radi8/TR-Switch/Photo1.jpg

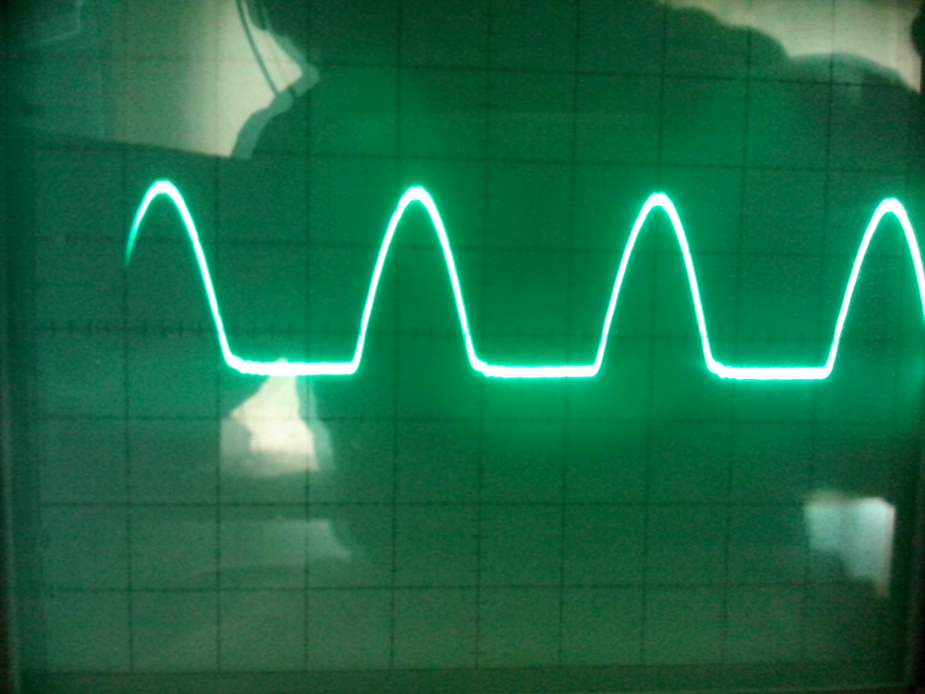
Photo1.jpg
