radi8/TR-Switch/Photo2.jpg

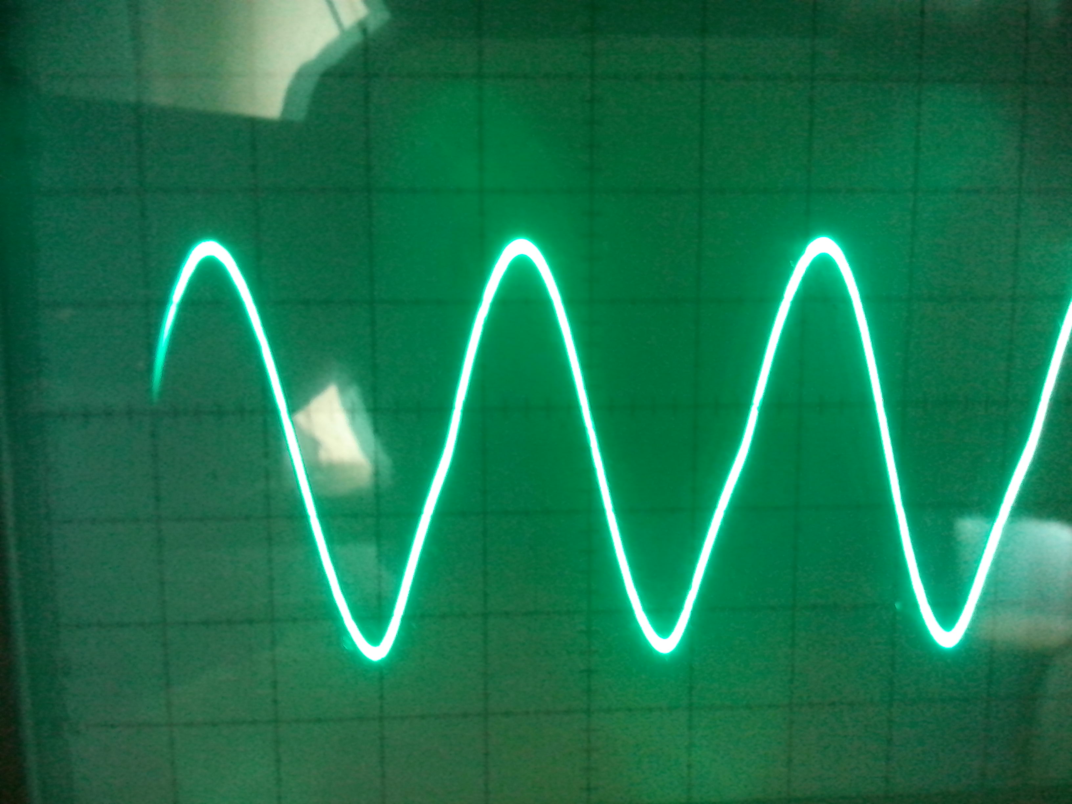
Photo2.jpg
