radi8/TR-Switch/README

This is the development of an article on making a TR-Switch using common rectifier diodes as a PIN diode substitute.
