radi8/TR-Switch/FinalGraphs/VNA_140301_164818.pdf

# Through Capacitors with diodes bridged, no chokes

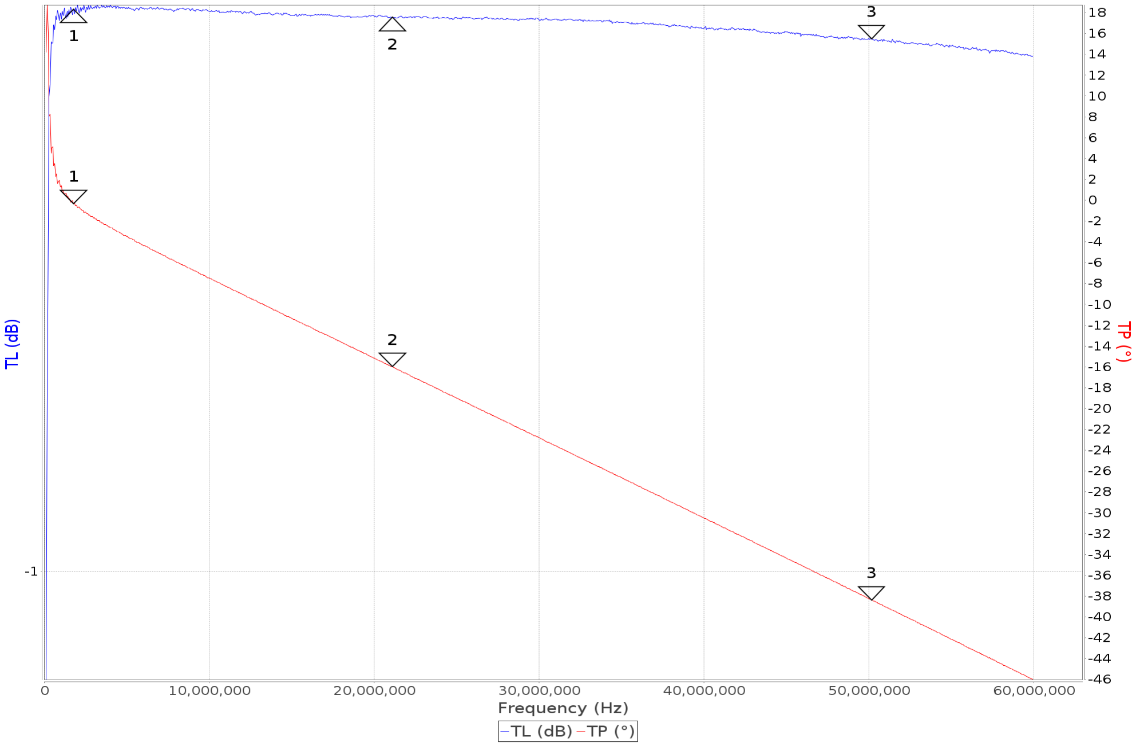
[picture p3: figure]

## Comment:

Date: | 1/03/14 4:48 PM
Mode: | Transmission
Analyser: | miniVNA-pro / mini radio solutions - miniVNA pro
Scan
Start: | 100000 / 100,000
Stop: | 59999917 / 59,999,917
Samples: 1047
Overscan: 1
Calibration
Samples: 2000
Overscan: 1
File: | TRAN_miniVNA-pro.cal
User: | gvj

## Plot generated on 1/03/2014, 4:48:19 PM

Marker | Freq. (Hz) | RL (dB) | RP (°) | TL (dB) | TP (°) | SWR | |Z| () | Rs () | Xs ()
1 | 1,759,119 | 0.00 | 0.00 | -0.04 | -0.32 | 0.00:1 | 0.0 | 0.0 | 0.0
2 | 21,096,437 | 0.00 | 0.00 | -0.06 | -15.98 | 0.00:1 | 0.0 | 0.0 | 0.0
1-2 | 19,337,318 | 0.00 | 0.00 | 0.01 | 15.66 | --- | 0.0 | 0.0 | 0.0
3 | 50,159,625 | 0.00 | 0.00 | -0.09 | -38.39 | 0.00:1 | 0.0 | 0.0 | 0.0
© DL2SBA 2013 | vna/J Version 2.8.6c | http://vnaj.dl2sba.com

## Plot generated on 1/03/2014, 4:48:19 PM

© DL2SBA 2013 | vna/J Version 2.8.6c | http://vnaj.dl2sba.com
