radi8/TR-Switch/FinalGraphs/VNA_140301_170526.pdf

# Antenna choke installed

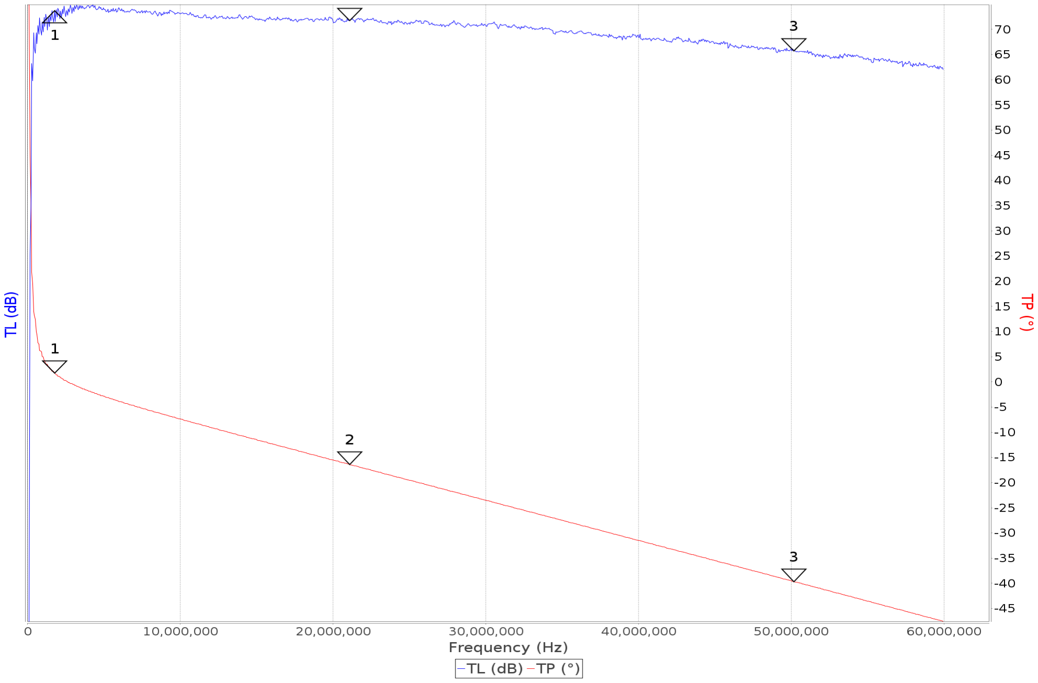
[picture p4: figure]

## Comment:

Date: | 1/03/14 5:05 PM
Mode: | Transmission
Analyser: | miniVNA-pro / mini radio solutions - miniVNA pro
Scan
Start: | 100000 / 100,000
Stop: | 59999917 / 59,999,917
Samples: 1047
Overscan: 1
Calibration
Samples: 2000
Overscan: 1
File: | ---
User: | gvj

## Plot generated on 1/03/2014, 5:05:26 PM

Marker | Freq. (Hz) | RL (dB) | RP (°) | TL (dB) | TP (°) | SWR | |Z| () | Rs () | Xs ()
1 | 1,759,119 | 0.00 | 0.00 | -0.04 | 1.73 | 0.00:1 | 0.0 | 0.0 | 0.0
2 | 21,096,437 | 0.00 | 0.00 | -0.05 | -16.38 | 0.00:1 | 0.0 | 0.0 | 0.0
1-2 | 19,337,318 | 0.00 | 0.00 | 0.01 | 18.11 | --- | 0.0 | 0.0 | 0.0
3 | 50,159,625 | 0.00 | 0.00 | -0.08 | -39.66 | 0.00:1 | 0.0 | 0.0 | 0.0
© DL2SBA 2013 | vna/J Version 2.8.6c | http://vnaj.dl2sba.com
