radi8/TR-Switch/CvsV.png

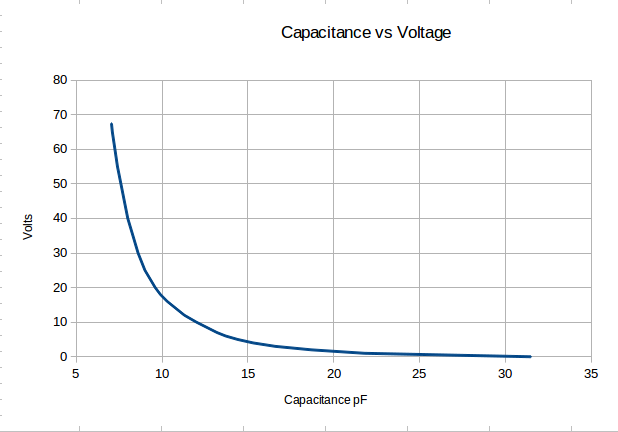
CvsV.png
