radi8/TR-Switch/CvsVplusLegend.png

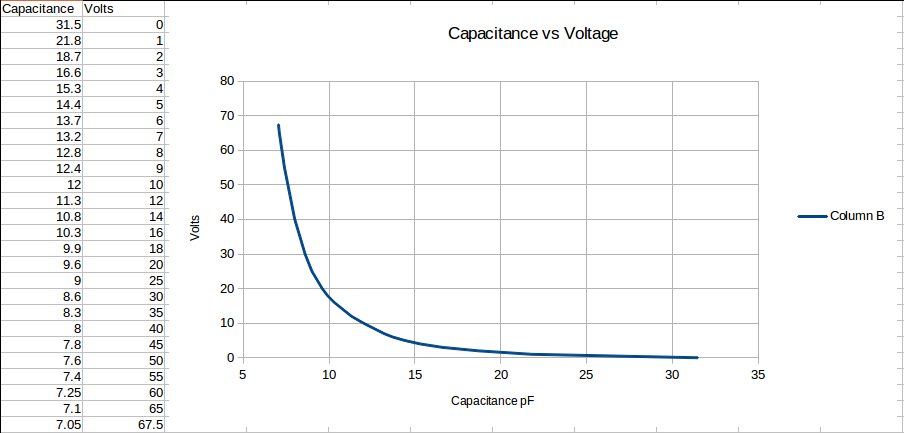
CvsVplusLegend.png
