radi8/TR-Switch/fig1_PIN.jpg

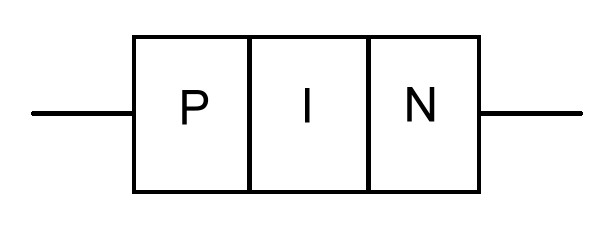
fig1_PIN.jpg
