radi8/TR-Switch/fig2.png

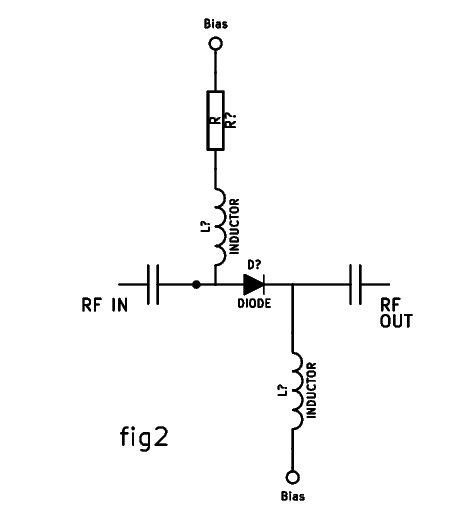
fig2.png
