radi8/TR-Switch/fig3.png

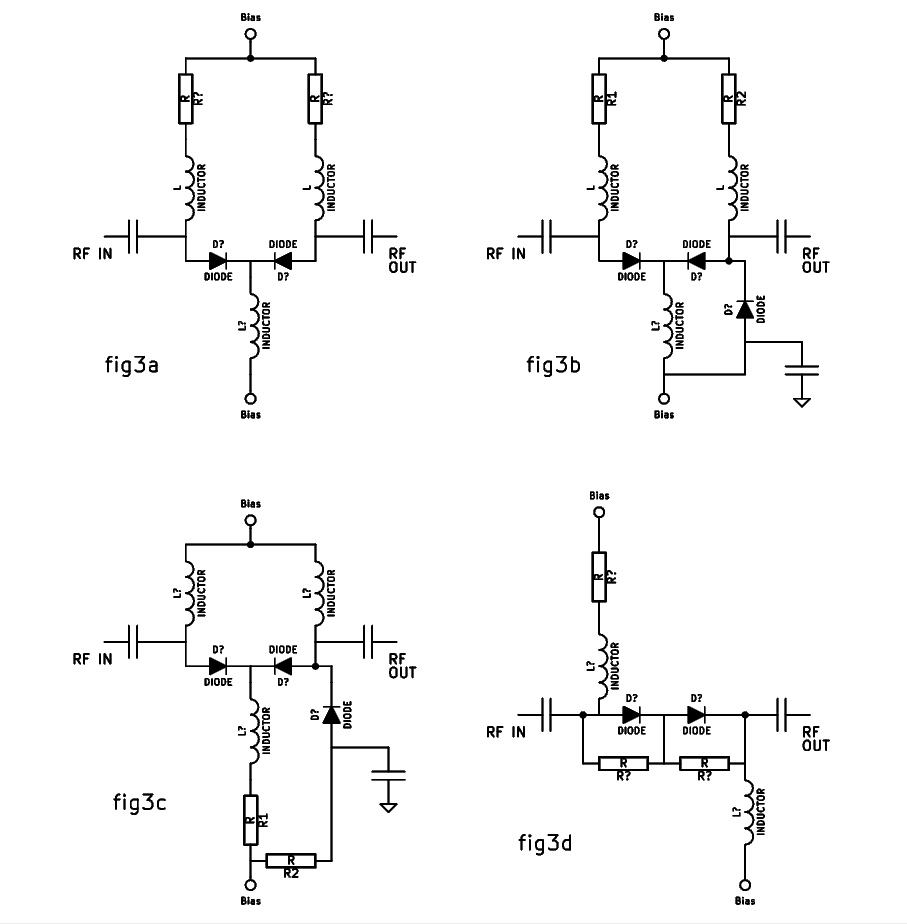
fig3.png
