radi8/TR-Switch/fig4.jpg

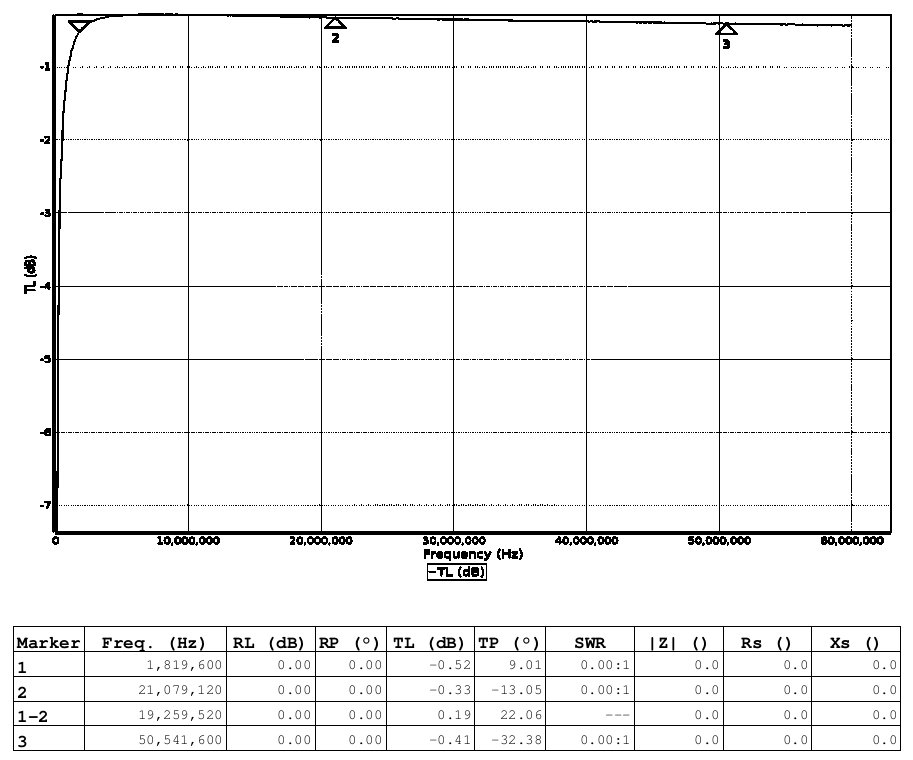
fig4.jpg
