radi8/TR-Switch/fig4.png

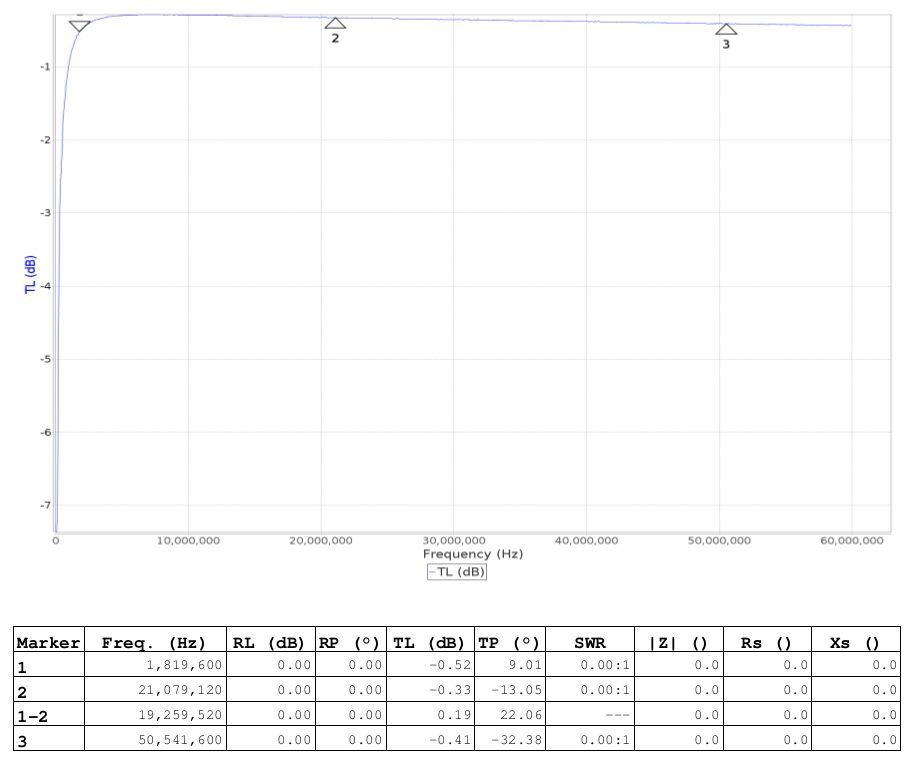
fig4.png
