radi8/TR-Switch/fig5.png

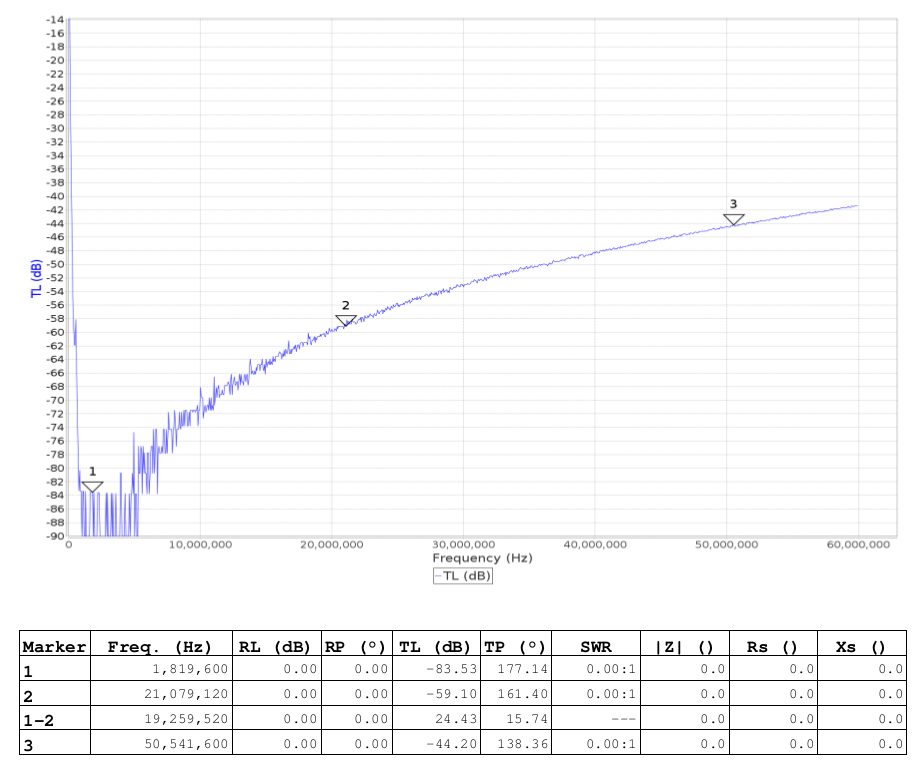
fig5.png
