radi8/TR-Switch/GP10Ycap.png

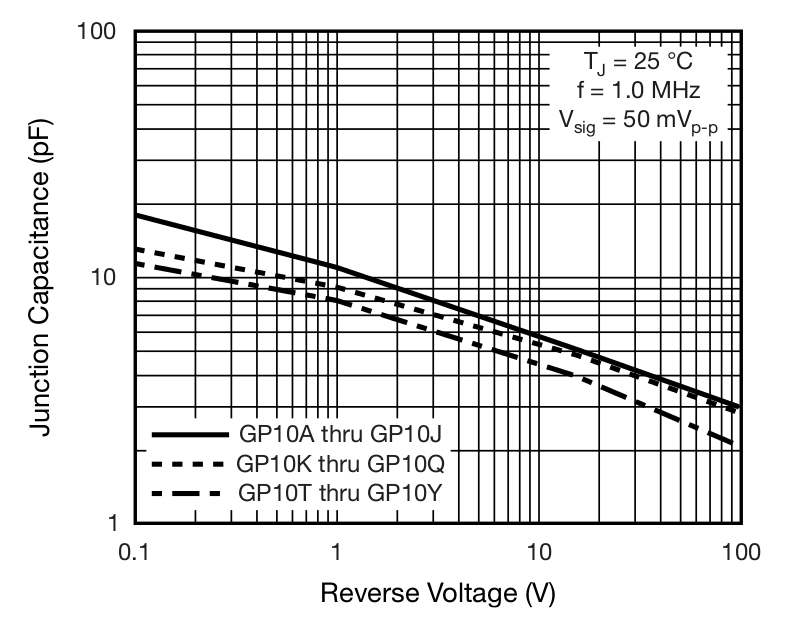
GP10Ycap.png
