radi8/TR-Switch/Resource/H-Bridge.gif

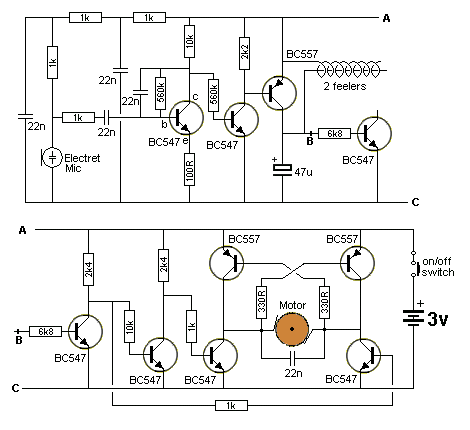
Resource/H-Bridge.gif
