radi8/TR-Switch/Resource/One-InputH_Bridge.gif

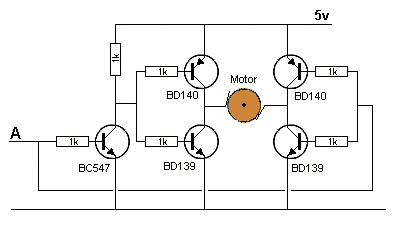
Resource/One-InputH_Bridge.gif
