radi8/TR-Switch/Screenshot from 2014-02-13 13:12:25.png

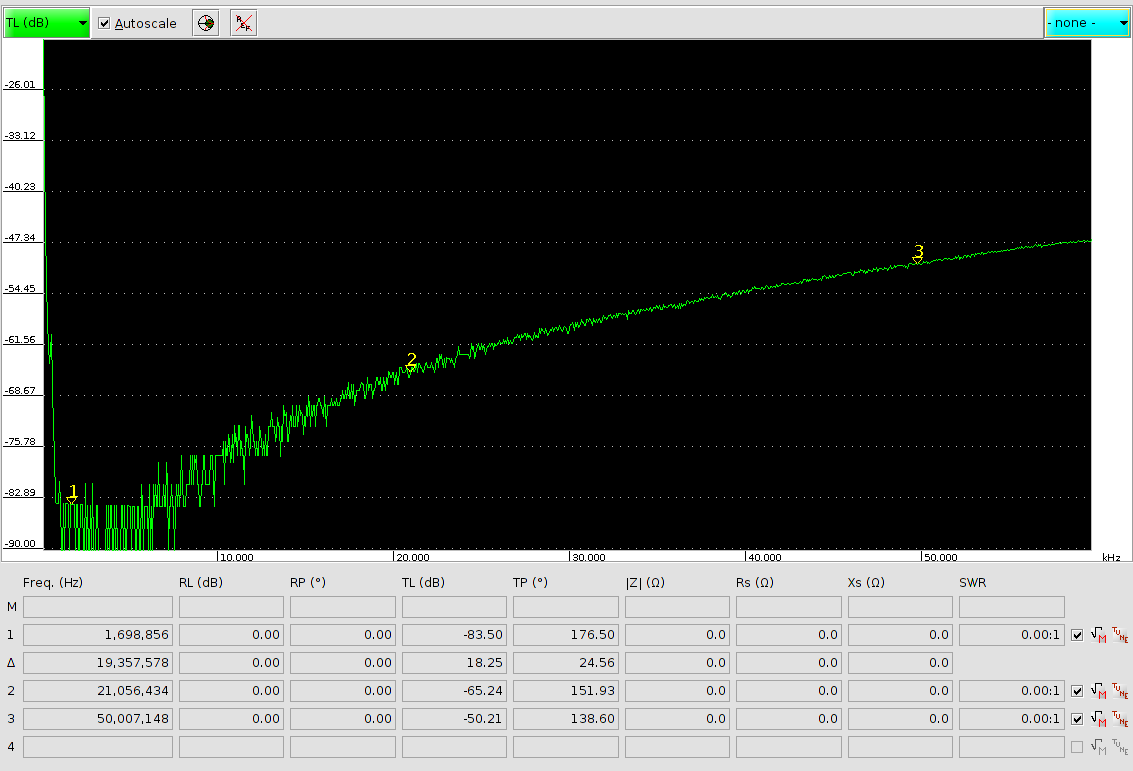
Screenshot from 2014-02-13 13:12:25.png
