radi8/TR-Switch/Table1.png

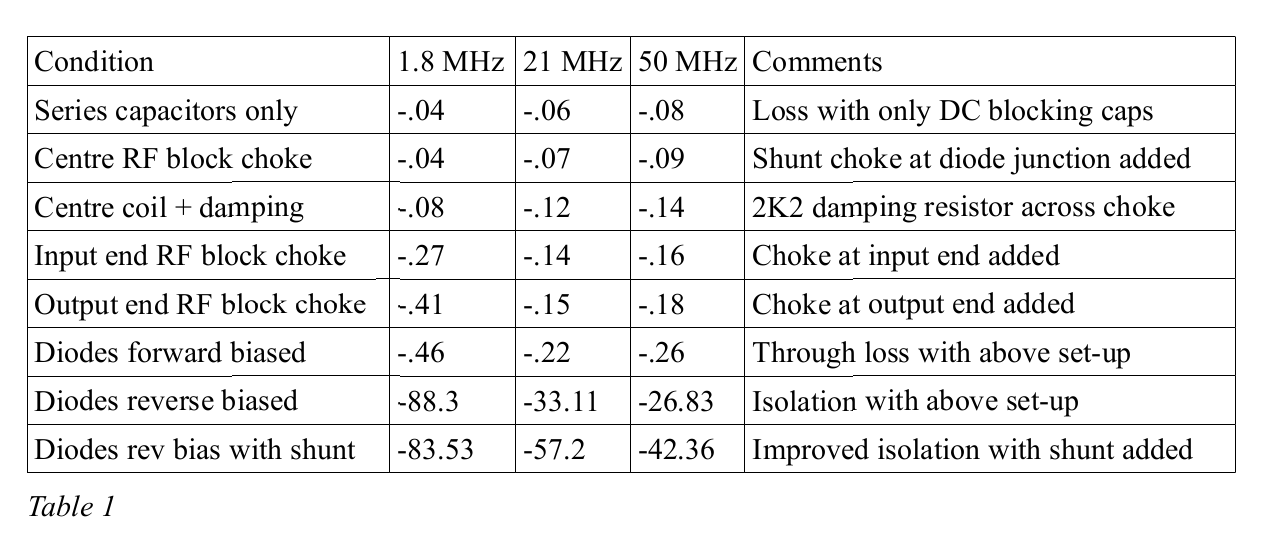
Table1.png
