radi8/TR-Switch/TRswitch/TRswitch.sch

## KiCad design TRswitch/TRswitch.sch (2014-02-20)

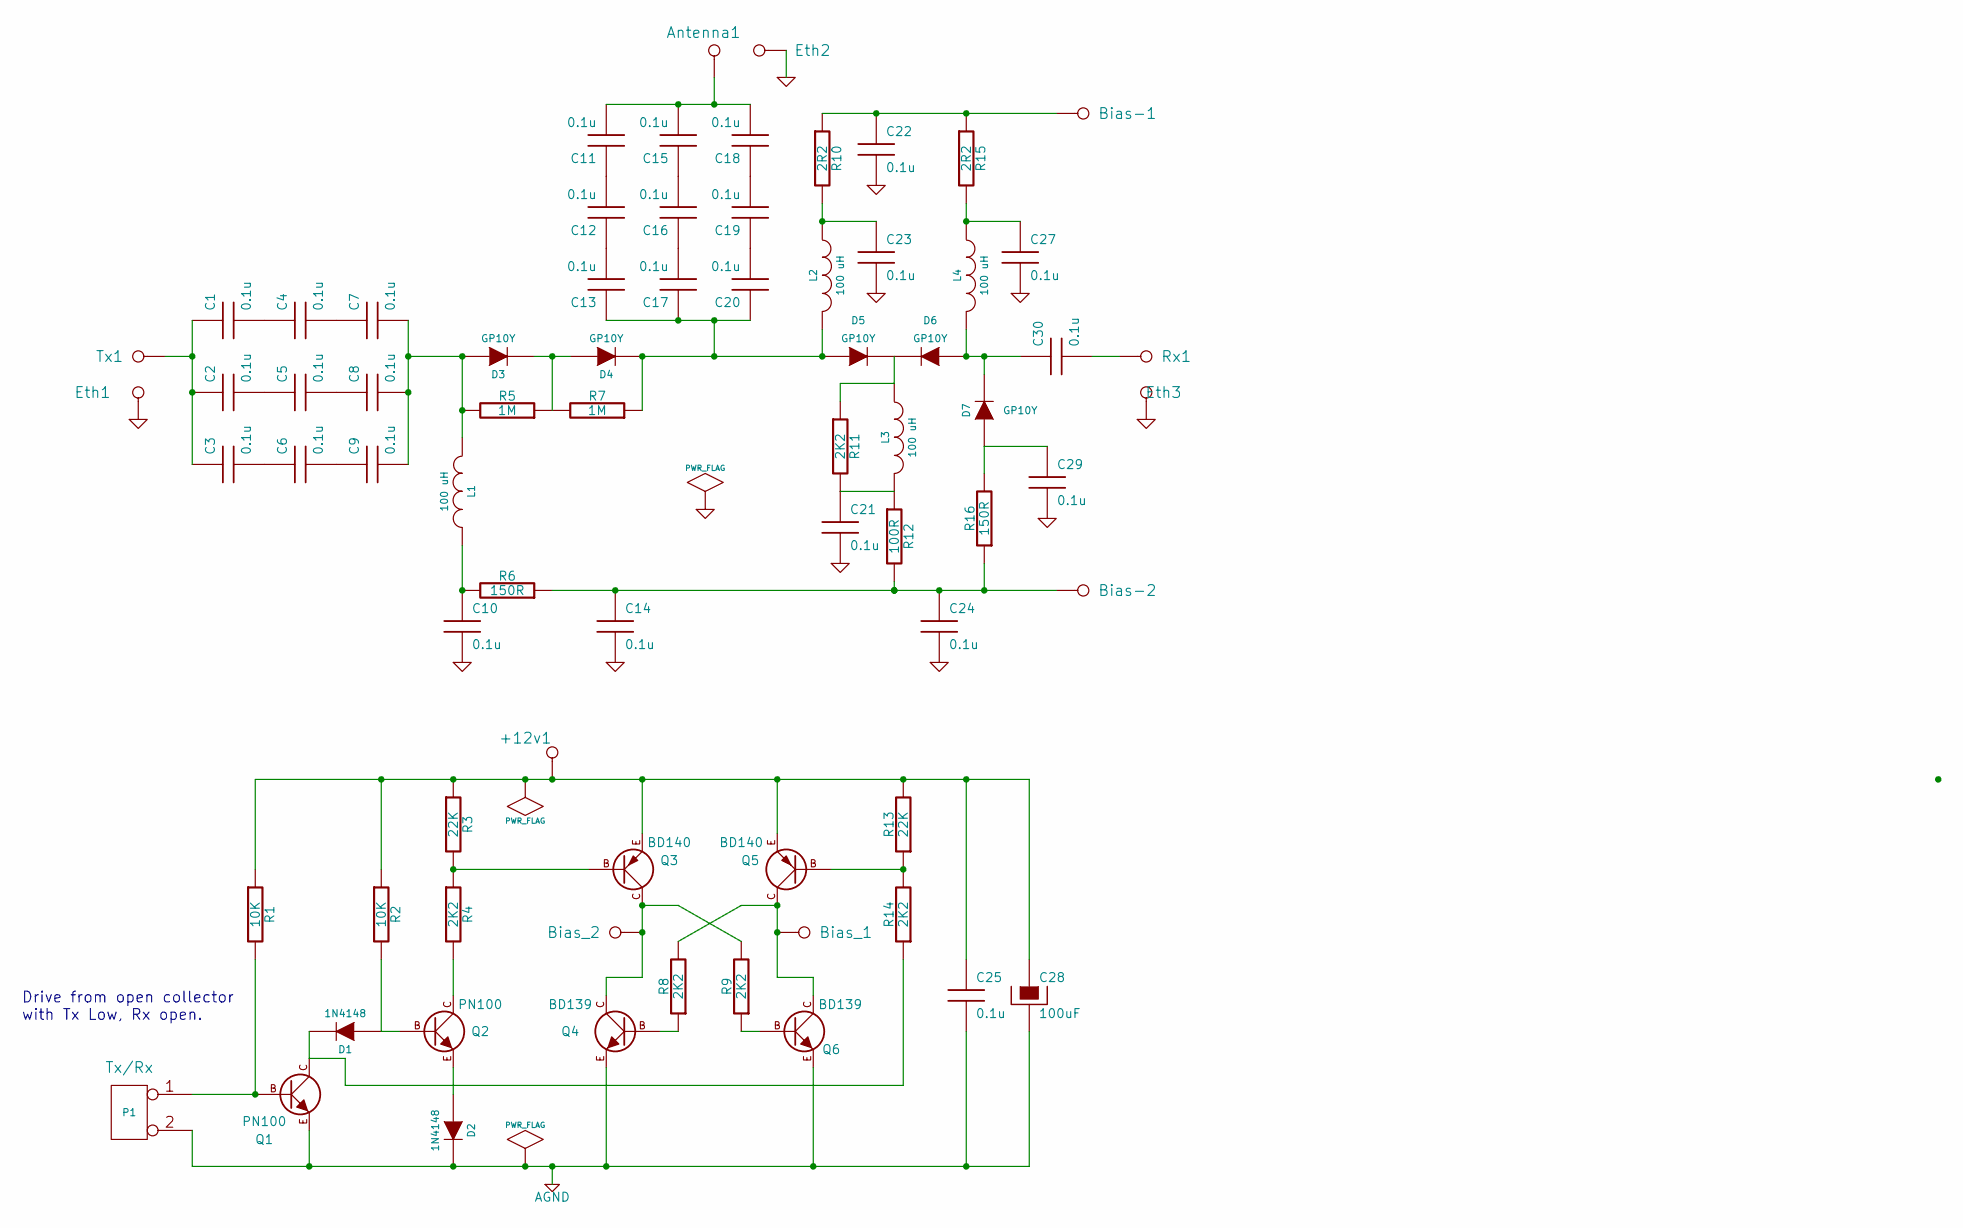
[picture p23: schematic TRswitch.sch]

Parts:
+12v1: CONN_1
Antenna1: CONN_1
Bias-1, Bias-2: CONN_1
Bias_1, Bias_2: CONN_1
C1, C2, C3, C4, C5, C6, C7, C8, C9, C10, C11, C12, C13, C14, C15, C16, C17, C18, C19, C20, C21, C22, C23, C24, C25, C27, C29, C30: 0.1u
C28: 100uF
D1, D2: 1N4148
D3, D4, D5, D6, D7: GP10Y
Eth1, Eth2, Eth3: CONN_1
L1, L2, L3, L4: 100 uH
P1: Tx/Rx
Q1, Q2: PN100; TO92-EBC
Q3, Q5: BD140
Q4, Q6: BD139; TO92-EBC
R1, R2: 10K
R3, R13: 22K
R4, R8, R9, R11, R14: 2K2
R5, R7: 1M
R6, R16: 150R
R10, R15: 2R2
R12: 100R
Rx1: CONN_1
Tx1: CONN_1

Connections:
AGND: C25.2, C28.2, D2.2 (K), P1.2 (PM), Q1.E, Q4.E, Q6.E
GND: C10.2, C14.2, C21.2, C22.2, C23.2, C24.2, C27.2, C29.2, Eth1.1, Eth2.1, Eth3.1
unnamed: +12v1.1, C25.1, C28.1, Q3.E, Q5.E, R1.1, R2.1, R3.1, R13.2
unnamed: Antenna1.1, C11.2, C15.2, C18.2
unnamed: Bias-1.1, C22.1, R10.1, R15.1
unnamed: Bias-2.1, C14.1, C24.1, R6.1, R12.2, R16.1
unnamed: Bias_1.1, Q5.C, Q6.C, R8.2
unnamed: Bias_2.1, Q3.C, Q4.C, R9.2
unnamed: C1.1, C2.1, C3.1, Tx1.1
unnamed: C1.2, C4.1
unnamed: C2.2, C5.1
unnamed: C3.2, C6.1
unnamed: C4.2, C7.1
unnamed: C5.2, C8.1
unnamed: C6.2, C9.1
unnamed: C7.2, C8.2, C9.2, D3.1 (A), L1.1, R5.2
unnamed: C10.1, L1.2, R6.2
unnamed: C11.1, C12.2
unnamed: C12.1, C13.2
unnamed: C13.1, C17.1, C20.1, D4.2 (K), D5.1 (A), L2.2, R7.1
unnamed: C15.1, C16.2
unnamed: C16.1, C17.2
unnamed: C18.1, C19.2
unnamed: C19.1, C20.2
unnamed: C21.1, L3.2, R11.2, R12.1
unnamed: C23.1, L2.1, R10.2
unnamed: C27.1, L4.1, R15.2
unnamed: C29.1, D7.1 (A), R16.2
unnamed: C30.1, D6.1 (A), D7.2 (K), L4.2
unnamed: C30.2, Rx1.1
unnamed: D1.1 (A), Q2.B, R2.2
unnamed: D1.2 (K), Q1.C, R14.1
unnamed: D2.1 (A), Q2.E
unnamed: D3.2 (K), D4.1 (A), R5.1, R7.2
unnamed: D5.2 (K), D6.2 (K), L3.1, R11.1
unnamed: P1.1, Q1.B, R1.2
unnamed: Q2.C, R4.2
unnamed: Q3.B, R3.2, R4.1
unnamed: Q4.B, R8.1
unnamed: Q5.B, R13.1, R14.2
unnamed: Q6.B, R9.1

Notes on the sheet:
Drive from open collector with Tx Low, Rx open.
