radi8/TR-Switch/TRswitch/fig2.sch

## KiCad design TRswitch/fig2.sch (2014-02-05)

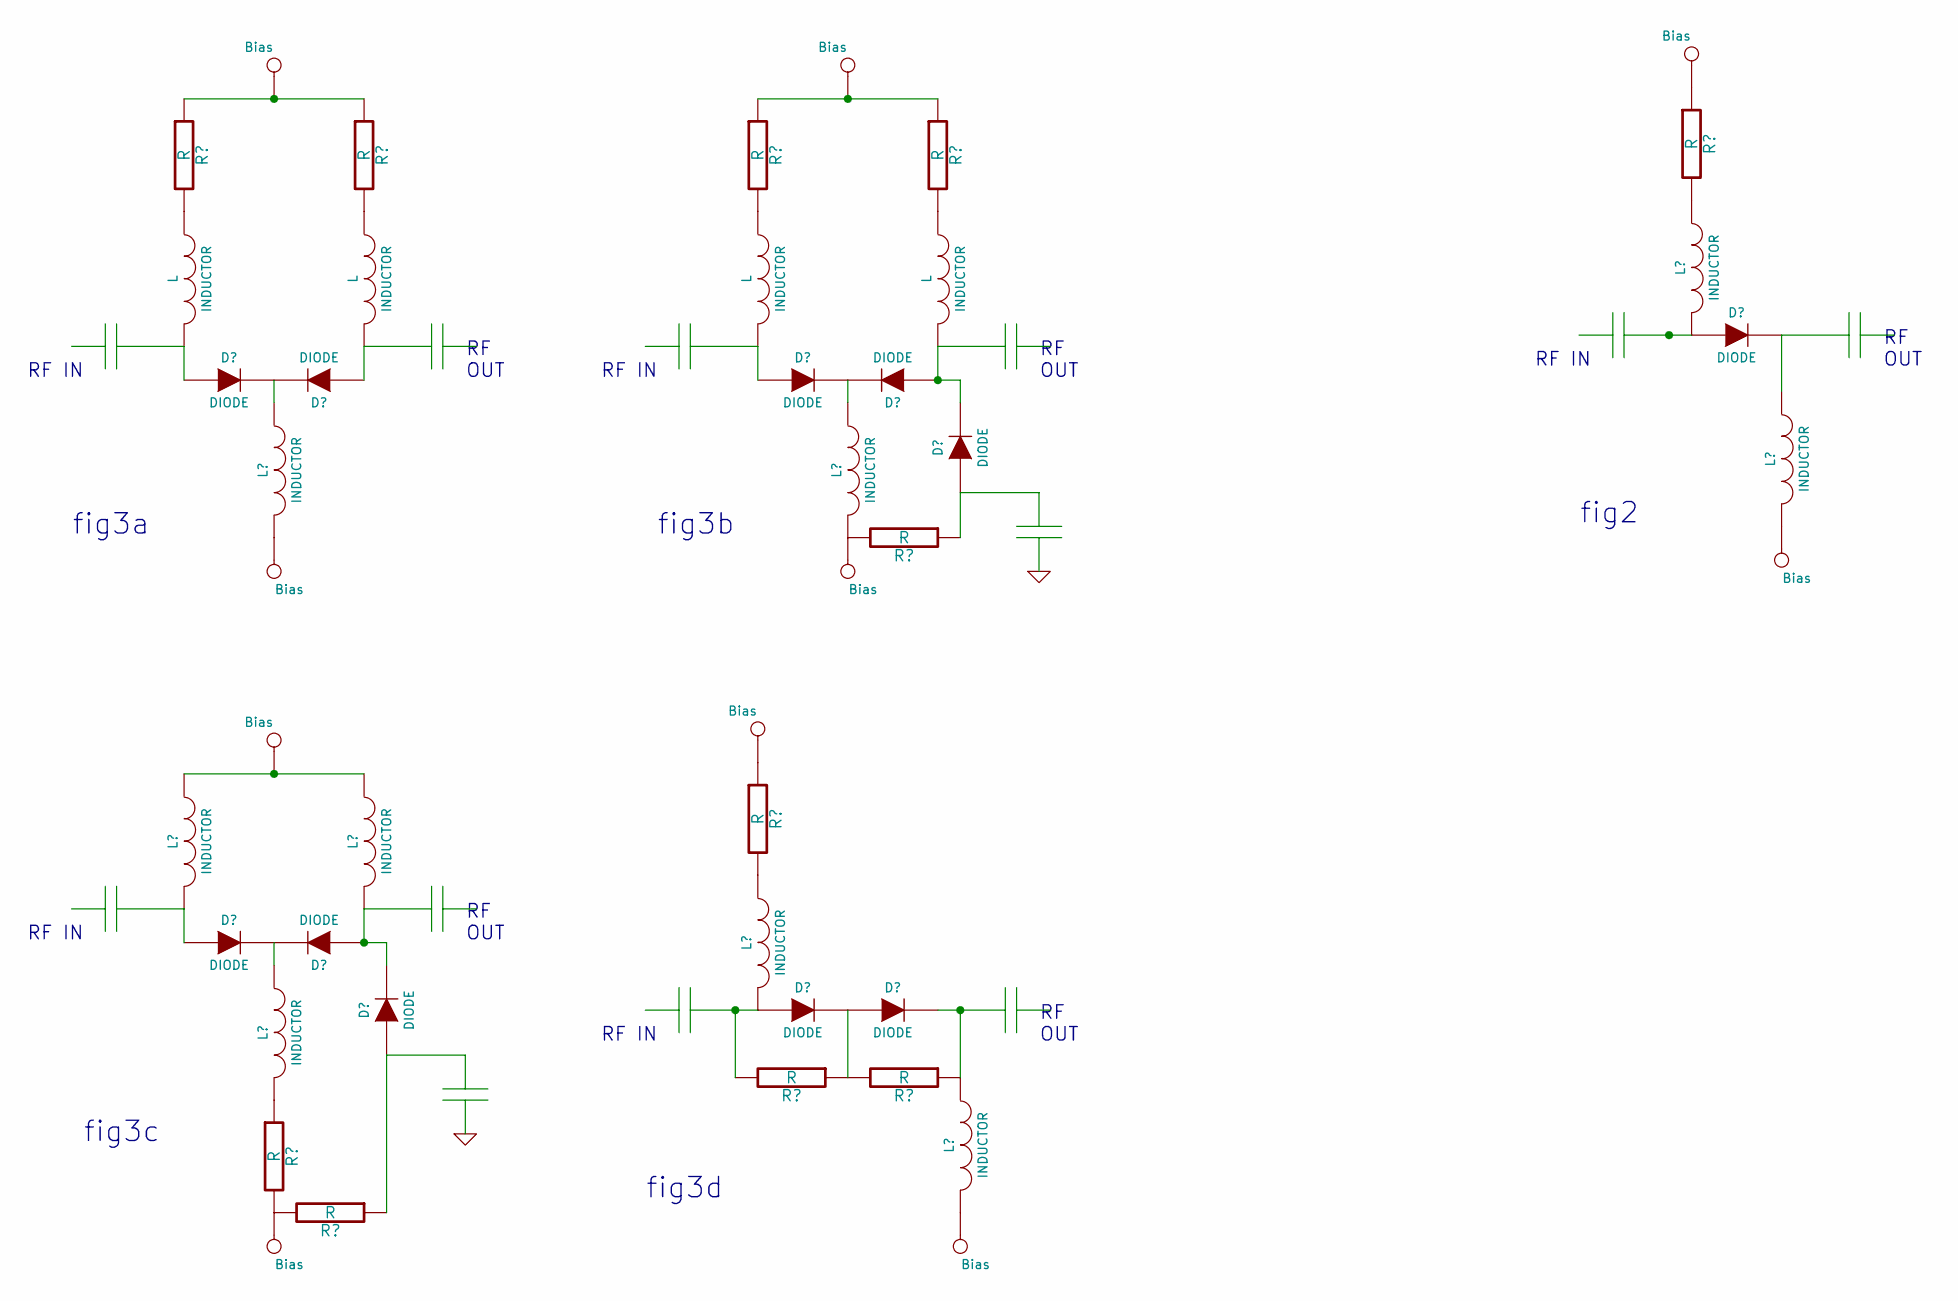
[picture p24: schematic fig2.sch]

Parts:
Bias: CONN_1
L: INDUCTOR

Notes on the sheet:
fig2
RF OUT
RF IN
fig3d
fig3c
fig3b
fig3a
