radi8/TR-Switch/(commit log)

2014-02-04 Added work from Shack computer
    [CapCurve.ods]
2014-02-05 Kicad files added
    [TRswitch.sch, fig2.sch]
2014-02-05 Table1 & GP10Y capacitance added
2014-02-05 Work on text and fig2
    [TRswitch.sch]
2014-02-12 Changes to TRswitch schematic
    [TRswitch.sch]
2014-02-14 More work on schematic
    [TRswitch.sch]
2014-02-18 Started on PCB Layout
    [$savepcb.brd, TRswitch.brd, TRswitch.sch]
2014-02-18 Work on antenna switch PCB
    [$savepcb.brd, TRswitch.brd]
2014-02-19 More work on PCB
    [$savepcb.brd, TRswitch.brd, TRswitch.sch]
2014-02-19 Track borders placed on PCB
    [$savepcb.brd, TRswitch.brd]
2014-02-20 Reduced size of PCB
    [$savepcb.brd, TRswitch.brd, TRswitch.sch]
2014-02-20 PCB now completed
    [$savepcb.brd, TRswitch.brd]
2014-02-20 Some tweaks to PCB
    [$savepcb.brd, TRswitch.brd]
2015-02-26 Added a file
    [CapCurve2.ods]
